Fuhua-Chen/kicad-lib/README.md

# kicad-lib

#### 项目介绍
kicad开发的库文件，包含符号，pcb和一些框架范例等等

### 子模块
为适应开发，加入了LCSMT库
