Fuhua-Chen/kicad-lib/PCB工艺要求.xls

Sheet: Sheet1
PCB加工工艺要求说明书
文件名： |  |  |  | 版本号： |  |  | 物料名称：
PCB加工要求：
 |  |  |  |  |  |  |  |  |  | 附图
 | 1.数 量： |  |  | 块 |  |  |  | 12.交货日期：
 | 2.层 数：
 | 3.尺 寸： |  |  |  | mm | X |  | mm
 | 4.板 厚：
 | 5.材 料： |  |  |  |  | 其他材料：
 | 6.铜箔厚度： |  | 外层 |  |  | 内层 |  | 12.表面涂层：
 | 7.阻 焊： |  |  |  | 颜 色： |  |  | 13.加工厂商标记：
 | 8.字 符： |  |  |  | 颜 色： |  |  |  | UL标记
 | 9.过孔处理方式： |  |  |  |  |  |  |  | 制作日期
 | 10.测 试：
 | 11.拼 板：
 | 14.设计软件及其版本：
 | 15.交货方式：
 | 16.其 他：
 | 17. 提供贴片钢网文件 |  |  |  | 提供生产Gerber文件 |  |  |  | 提供生产Gerber文件确认后再生产
其他特殊说明：
孔径公差：沉铜孔+/-3mil,非沉铜孔+/-2mil,VIA孔+3/-mil, 钻槽公差: +/-5mil, 未注内外角:R40mil(max), 外形公差:+/-5mil。
公司名称 |  | pinno.cc
部门： |  | 研发部
联系人：
邮箱：
地址：

Sheet: Sheet2
无
1张 | 单面 | 0.2mm | H/H oz | H/H oz | 单面 | 绿色 | 白色 | Gerber 文件 | FR-4 | 年周 | 无铅标记 | 有铅喷锡 | 覆盖 | 陈福华15521193581 | excfh@live.cn
2张 | 双面 | 0.3mm | 1/1 oz | 1/1 oz | 双面 | 红色 | 黑色 | Protel Dos | FR-4TG170 | 周年 | 防静电 | 无铅喷锡 | 不覆盖
3张 | 三层 | 0.4mm | 2/2 oz | 2/2 oz | 无 | 蓝色 | 黄色 | PADS 2005 | Rogers 4003 | 年月日 |  | 化学沉金 | 部分覆盖
4张 | 四层 | 0.5mm | 3/3 oz | 3/3 oz |  | 黑色 | 红色 | PADS 2005SP2 | Rogers 4350 | 日月年 |  | OSP(防氧化） | 部分塞孔
5张 | 五层 | 0.6mm | 4/4 oz | 4/4 oz |  | 白色 | 其它规格 | PADS 2007 | Ro 其它型号 | 其它 |  | 沉锡 | 覆盖不塞
6张 | 六层 | 0.7mm | 5/5 oz | 5/5 oz |  | 哑光绿色 |  | Protel 98 | Taconic系列 |  |  | 沉银 | 覆盖塞孔
7张 | 七层 | 0.8mm | 6/6 oz | 6/6 oz |  | 哑光黑色 |  | Protel 99SE | 铝基材料 |  |  | 其它 | 根据文件
8张 | 八层 | 0.9mm | 其它规格 | 其它规格 |  | 哑光蓝色 |  | Protel DXP | RF-35 |  |  |  | 其它
 | 九层 | 1.0mm |  |  |  | 太阳油墨 |  | PowerPCB 5.0 | Arlon
 | 十层 | 1.1mm |  |  |  | 其它规格 |  | Eagle5.0 | 其它
 | 十二层 | 1.2mm |  |  |  |  |  | Eagle6.0
 | 十四层 | 1.3mm |  |  |  |  |  | 其它格式
 | 十六层 | 1.5mm
 | 十八层 | 1.6mm
 | 二十层 | 1.8mm
 | 二十四层 | 2.0mm
 | 其它 | 2.4mm
 |  | 2.5mm
 |  | 3.0mm
 |  | 4.0mm
 |  | 5.0mm
 |  | 6.0mm
 |  | 其它规格
