Fuhua-Chen/kicad-lib/(commit log)

2018-10-10 增加期间
2018-10-11 增加器件
2018-10-14 更新符号和封装，添加到处bom脚本
2018-10-16 更新电容库
2018-10-18 增加和更新OCN连接器库
2018-10-19 增加everlight的红蓝LED
2018-10-19 增加符号SM05B-SRSS-TB
2018-10-19 更新jst符号错误
2018-10-22 增加移远EC20模块封装
2018-10-30 增加一些CJT连接器，LED，运放，可调电阻，传感器等
2018-10-31 添加器件CJ3134K
2018-11-22 增加了很多新器件
2018-11-25 增加了一些阻容，增加OLED 128*64 1.3inch,增加一个编码器及其3D
2018-11-25 修改了部分器件信息
2018-12-04 增加器件74LVC1T45DW-7，74LVC1T45W6-7
2018-12-04 增加MCZ0806AH900L2TA0G 及其封装，修改Sunltech封装和符号
2018-12-11 修改了SMW2012B371BTE、MCZ0806AH封装，修改了USBLC6-2SC符号信息
2018-12-12 增加泽耀科技2.4G模块AS01-SP2
2019-01-03 增加18Ω_1206電阻
2019-01-07 自此版本开始，阻容符号value值使用partnumber，使用时在原理图改为对应的值
2019-01-07 增加按键，修改PMIC
2019-01-08 增加38*38*6散热片及其封装，3D
2019-01-08 维护了一些器件信息
2019-01-09 增加插件3mm红色LED
2019-01-09 增加轻触开关TS-1187-B-A-B
2019-01-10 修改Module_2.4G_AS01-SP2_25x13x2.2mm.kicad_mod,改兼容过孔为贴片
2019-01-10 fuhua-home的缓存提交
2019-01-10 增加器件NL17SZ32XV5T2G
2019-01-10 维护已有电阻信息
2019-01-10 维护ME6209
2019-01-11 新增几种器件，原有器件信息维护
2019-01-11 提交合并
2019-01-11 维护逻辑器件信息
2019-01-11 合并pmic和resistor的差异
2019-01-12 增加连接器SM06B-SRSS-TB以及替代品A1002WR-S-6P
2019-01-12 修正SM06B连接器错误
2019-01-12 脚本更新
2019-01-13 增加MPU6050，SHT30，1730，APA102，SK9822，WS2812B-2020
2019-01-13 增加STML476RCT6,FM25F01-TS-T-G,维护封装信息
2019-01-16 增加移远BC20符号，未完成所有引脚设置
2019-01-18 增加PT334-6B封装
2019-01-21 维护电容信息
2019-01-22 增加防水audio和usb连接器
2019-01-29 更新TP4057规格书链接地址
2019-02-07 增加了很多新器件、封装、3D
2019-02-08 增加了spi flash ，led，阻容，连接器等，维护了部分器件信息
2019-02-09 增加了ZLG AW516模块，导电硅胶按键得PCB虚拟封装
2019-02-12 添加了一些器件和封装
2019-02-13 增加AHT10器件及其封装
2019-02-15 增加新器件，维护信息
2019-02-16 增加SM10B-SRSS-TB
2019-02-16 删除自动备份文件
2019-02-16 增加连接器1.25T-5PWT
2019-02-18 修改了风住哪个错误
2019-02-18 增加SIM_SIM-002-T6_17.2x15.3x1.25mm封装
2019-02-20 维护器件信息
2019-02-22 增加setup脚本，修改BOM输出脚本，增加kicad坐标文件转AD格式工具，来自立创社区
    [KiCAD 坐标格式整理.xlsm]
2019-02-22 维护MT1470信息
2019-02-25 "维护器件信息，增加连接器1.25mm 4pins
2019-02-27 维护MT1407,使其型号不可见
2019-02-28 增加1.25T-4PWT
2019-02-28 增加ABS210
2019-03-02 增加1R电阻 2512/1210
2019-03-04 增加MQ传感器链接的七星底座符号
2019-03-04 调整库的文件夹结构
2019-03-04 MQ连接器区分7P，6P
2019-03-04 变更命名方式为小写开头，避免与kicad官方库冲突
2019-03-05 卸载kicad 官方库，使用默认路径
2019-03-05 卸载kicad官方库在gitmodule的注册
2019-03-05 readme更新
2019-03-05 变更Raddiator为radiator文件夹
2019-03-05 增加Connector_MQ_Sensors_6P_D17xH15mm 增加Connector_MQ_Sensors_7P_D17xH15mm
2019-03-05 增加一些器件和封装
2019-03-06 增加了一些PMIC和肖特基二极管
2019-03-07 改变部分库的大写开头
2019-03-07 增加连接器和100uH电感
2019-03-07 重命名目录pinno-lib/footprint/Antenna.pretty为pinno-lib/footprint/AAntenna.pretty
2019-03-07 删除目录pinno-lib/footprint/AAntenna.pretty
2019-03-07 删除目录pinno-lib/footprint/Button.pretty
2019-03-07 删除目录pinno-lib/footprint/Display.pretty
2019-03-07 删除目录pinno-lib/footprint/Filter.pretty
2019-03-07 删除目录pinno-lib/footprint/LED.pretty
2019-03-07 删除目录pinno-lib/footprint/Module_2.4G.pretty
2019-03-07 删除目录pinno-lib/footprint/Module_4G.pretty
2019-03-07 删除目录pinno-lib/footprint/Package.pretty
2019-03-07 删除目录pinno-lib/footprint/Sensor.pretty
2019-03-07 删除目录pinno-lib/footprint/Switch.pretty
2019-03-07 删除目录pinno-lib/footprint/Varistor.pretty
2019-03-07 删除目录pinno-lib/packages3D/Radiator.3dshapes
2019-03-07 删除目录pinno-lib/packages3D/Switch.3dshapes
2019-03-08 LightSensor_ROHM_BH1730FVC_WSOF6_2.6X1.6X0.75mm 封装一脚指示明确
2019-03-16 增加STM32H750VBT6
2019-03-21 增加光耦和差分adc,变更3D和封装的文件结构，统一同一个文件夹
2019-03-23 增加NL17SZ14DFT2G
2019-03-24 增加电量指示芯片和反相器
2019-03-24 增加连接器
2019-03-24 更新错误封装
2019-04-01 增加部分器件
2019-04-01 增加二极管和电阻
2019-04-01 增加电阻和触摸IC，修正ir接受管的封装错误
2019-04-03 增加音频功放FM8002A
2019-04-04 增加连接器按键等多个封装
2019-04-07 增加几个连接器
2019-04-10 增加新器件
2019-04-18 增加电感和PMIC Signed-off-by: fuhua-chen <fuhua-chen@outlook.com>
2019-05-05 增加连接器封装
2019-05-05 封装信息维护
2019-05-05 增加ACP3225封装
2019-05-05 增加脚本
2019-05-05 更新封装
2019-05-08 增加FPC封装
2019-05-08 增加FPC连接器封装
2019-05-09 增加红外接收管 Signed-off-by: linlibing <978257694@qq.com>
2019-05-09 更新update脚本
2019-05-12 增加microusb连接器 Signed-off-by: fuhua-chen <fuhua-chen@outlook.com>
2019-05-15 更新AWM3150V
2019-05-17 维护logic
2019-05-23 更新AWMA3150
2019-06-02 更新STM32F072C8,CB符号错误
2019-06-09 增加一些连接器和芯片，二极管等
2019-06-12 变更ME6216封装为SOT-23，增加一些器件
2019-07-01 增加电阻
2019-07-07 增加LED
2019-07-25 更新移远EC20封装 Signed-off-by: fuhua-chen <fuhua-chen@outlook.com>
2019-08-06 推送更新
2019-08-07 增加pinheader2x10
2019-08-29 增加器件 Signed-off-by: fuhua-chen <fuhua-chen@outlook.com>
2019-09-01 更新元器件库，更新BOM脚本，可以识别DNP“的器件并不导出”
2019-09-24 增加了部分器件和封装
2019-10-21 更新 Signed-off-by: fuhua-chen <fuhua-chen@outlook.com>
2019-11-28 更新器件
2019-11-28 增加H7PI扩展版的封装
2019-11-28 增加H7PI扩展板符号
2019-11-28 增加1.3寸OLED
2020-01-21 更新，update
2020-01-26 update lib，update bom script Signed-off-by: fuhua-chen <fuhua-chen@outlook.com>
2020-02-22 更改库名字,更新器件
2020-04-05 update, addd pinno_pos2xlsx script
    [KicadPosition2AD.xlsm]
2020-04-24 修改脚本pinn_pos_converter,转换文件用于贴片机识别
